Venura-Shiromal/Advanced-Light-Intensity-Indicator/Images/PCB_3D.png

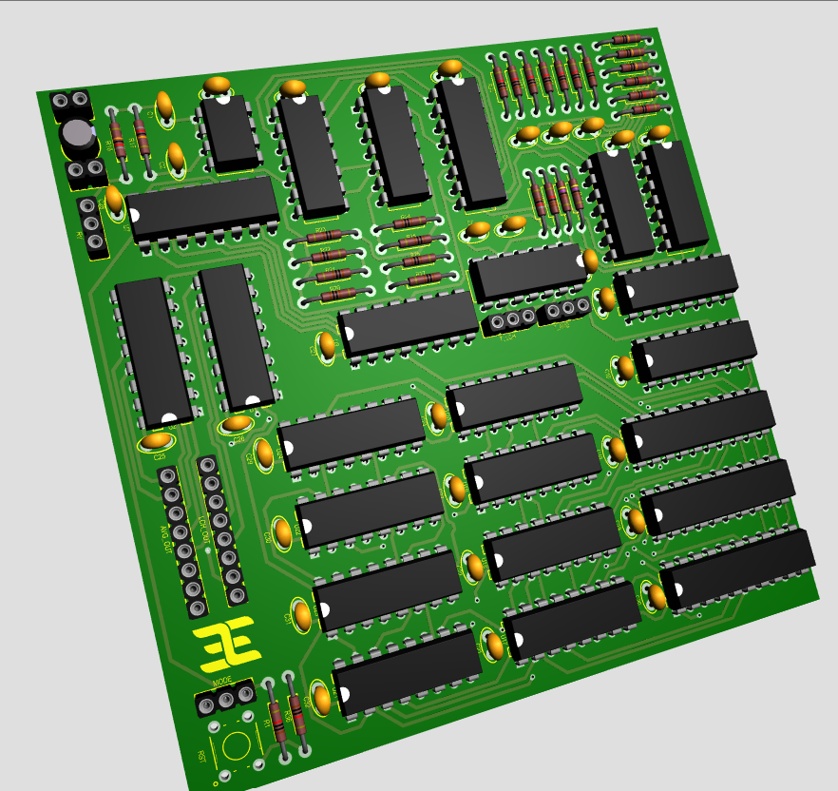
Images/PCB_3D.png
