Venura-Shiromal/Advanced-Light-Intensity-Indicator/Images/PCB_Layout.png

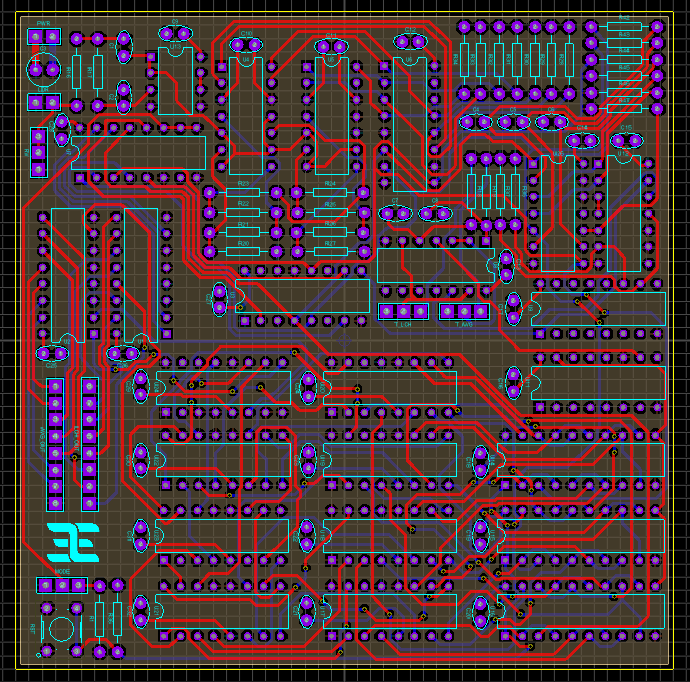
Images/PCB_Layout.png
