Venura-Shiromal/Advanced-Light-Intensity-Indicator/Images/Prototype1.png

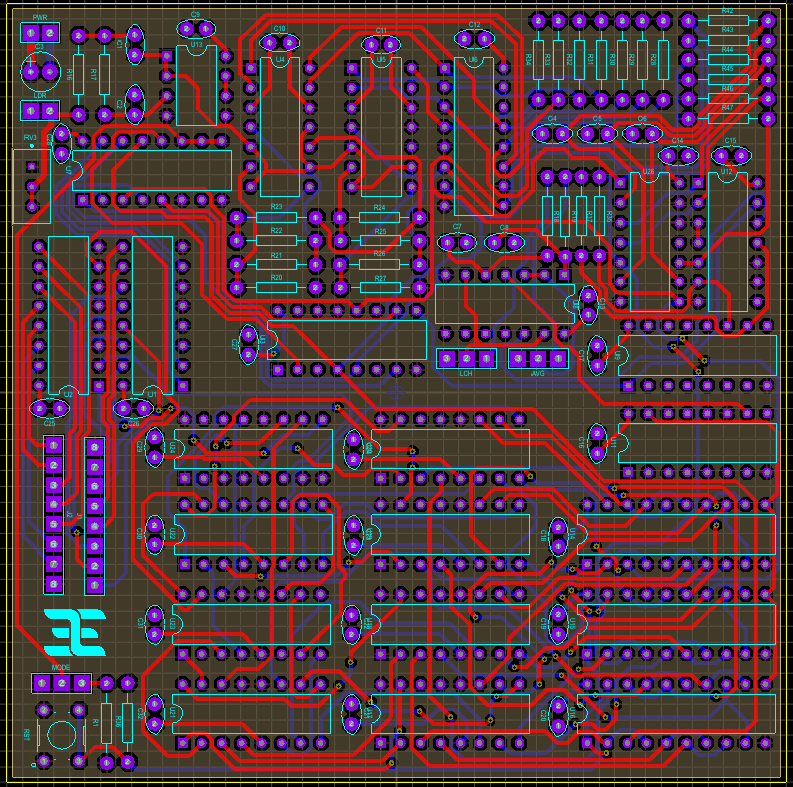
Images/Prototype1.png
