Venura-Shiromal/Advanced-Light-Intensity-Indicator/Simulations/LTSpice/Filter/Plots/Bode_Plot.jpg

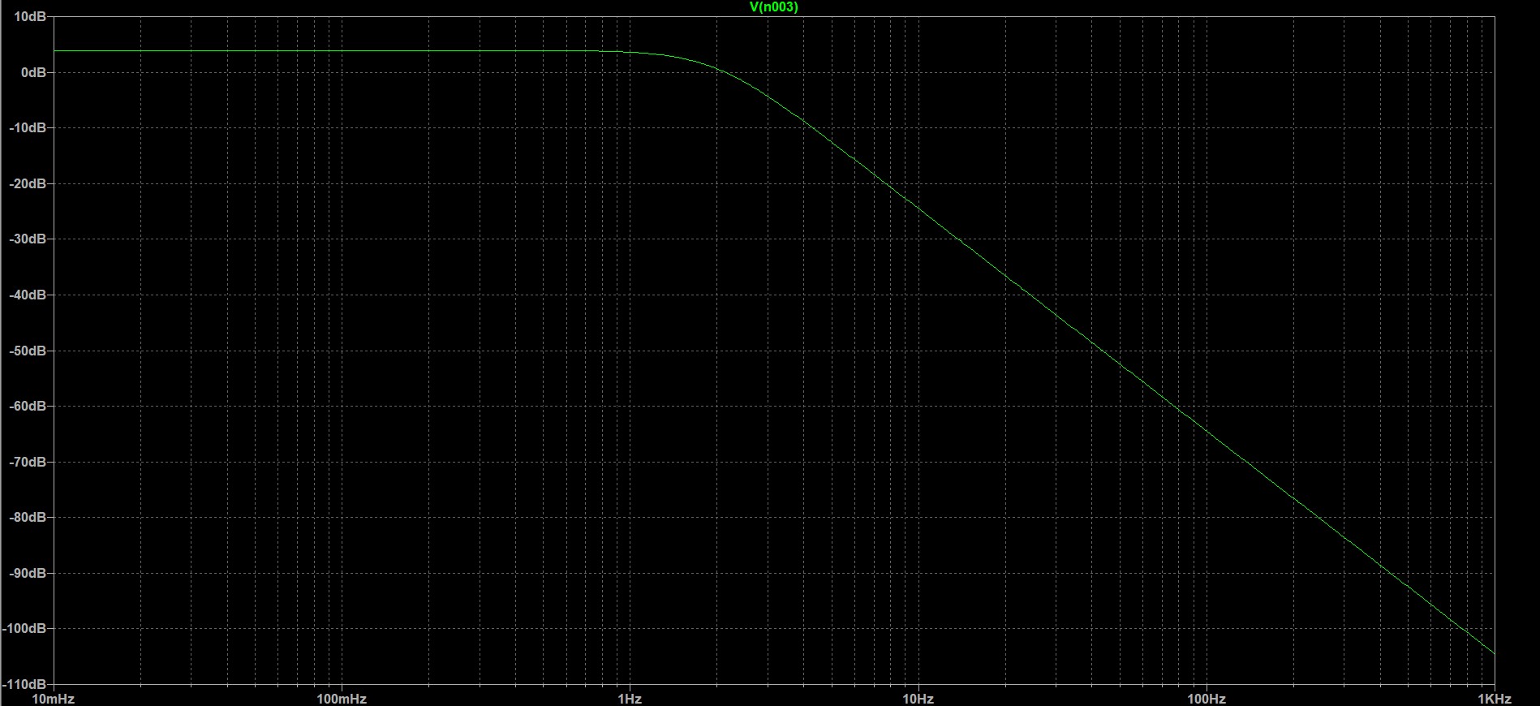
Simulations/LTSpice/Filter/Plots/Bode_Plot.jpg
