Venura-Shiromal/Advanced-Light-Intensity-Indicator/Simulations/LTSpice/Filter/Plots/Bode_Plot_Zoomed.jpg

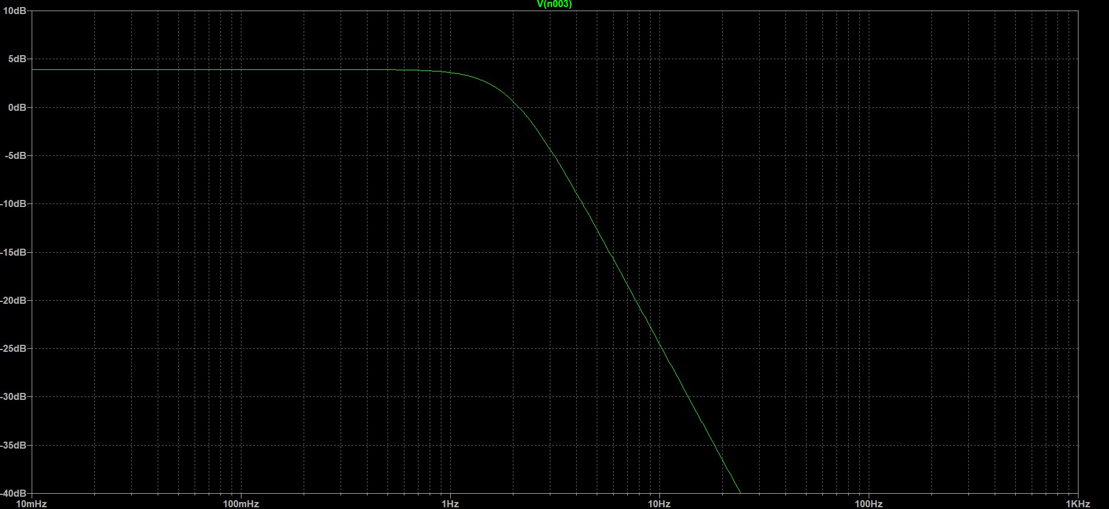
Simulations/LTSpice/Filter/Plots/Bode_Plot_Zoomed.jpg
