Venura-Shiromal/Advanced-Light-Intensity-Indicator/Simulations/LTSpice/Filter/Plots/BodePlot_UnityGain.jpg

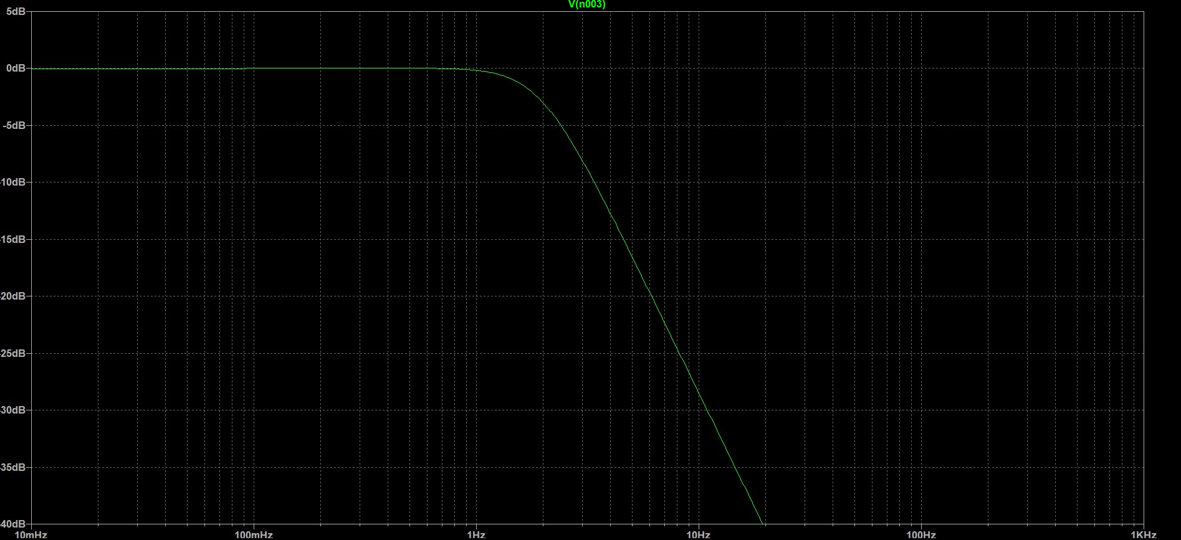
Simulations/LTSpice/Filter/Plots/BodePlot_UnityGain.jpg
