Venura-Shiromal/Advanced-Light-Intensity-Indicator/Simulations/LTSpice/Filter/Plots/BodePlot_UnityGain_v2.jpg

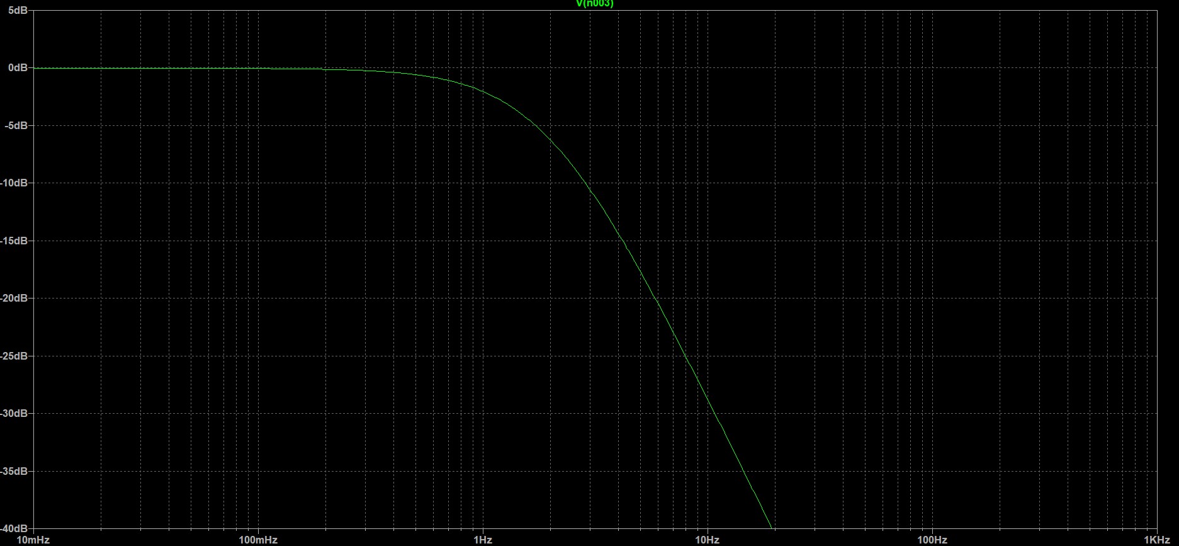
Simulations/LTSpice/Filter/Plots/BodePlot_UnityGain_v2.jpg
