Venura-Shiromal/Advanced-Light-Intensity-Indicator/Documents/Bill_of_Materials.xlsx

Category | Qt. | Value | Description | Store | Unit Price (Rs) | Price
Capacitors | 2 | 1uF | Ceramic (Clock) | Hexa Node | 5 | 10
Capacitors | 29 | 100nF | Ceramic | Hexa Node | 8 | 232
Capacitors | 1 | 100uF | Electrolyt | Duino | 6 | 6
Resistors | 10 | 820k | Resistors (Filter) | Duino | 1.5 | 15
Resistors | 10 | 10k | Resistors (Pull Up/Pull Down) | Duino | 1.5 | 15
Resistors | 14 | 330 | Resistors (7-Segment Display) | Department | 0 | 0
Resistors | 10 | 8.2k | Resistors (Clock) | Duino | 1.5 | 15
Resistors | 8 | 1k | Resistors (Comparator Ladder) | Department | 0 | 0
Resistors | 10 | 100k | Resistors (Change Detector) | Duino | 1.5 | 15
Resistors | 1 | 20k | Potentiometer (Trimmer) | Duino | 45 | 45
Resistors | 1 | 20k | Potentiometer | Duino | 80 | 80
Resistors | 1 | 100k | Potentiometer | Duino | 65 | 65
Integrated Circuits | 2 | CD4511 | 7 Segment BCD Decoder | Department | 0 | 0
Integrated Circuits | 1 | MCP6002 | Filter Op-Amp | Hexa Node | 75 | 75
Integrated Circuits | 2 | LM339N | Flash ADC Comparators | Department | 0 | 0
Integrated Circuits | 1 | 74HC148 | Priority Encoder | Department | 0 | 0
Integrated Circuits | 1 | CD4053 | Multiplexer | Hexa Node | 42 | 42
Integrated Circuits | 1 | 74HC14 | Inverter | Hexa Node | 110 | 110
Integrated Circuits | 1 | CD40175 | Quad D Flip Flop | Hexa Node | 200 | 200
Integrated Circuits | 2 | CD4040 | 12 Stage Counter | Hexa Node | 65 | 130
Integrated Circuits | 1 | 74HC32N | OR | Duino | 55 | 55
Integrated Circuits | 3 | 74LS273 | Octal D Flip Flop | Hexa Node | 110 | 330
Integrated Circuits | 1 | CD4070 | XOR | Hexa Node | 75 | 75
Integrated Circuits | 8 | 74LS83 | 4-Bit Full Adder | Hexa Node | 120 | 960
Integrated Circuits | 1 |  | 8-pin IC Socket | Duino | 12 | 12
Integrated Circuits | 20 |  | 16-pin IC Socket | Duino | 20 | 400
Integrated Circuits | 3 |  | 20-pin IC Socket | Duino | 30 | 90
Miscellaneous | 1 |  | LDR | Department | 0 | 0
Miscellaneous | 2 |  | 7 Segment Display | Department | 0 | 0
Miscellaneous | 1 |  | Switch |  |  | 0
Miscellaneous | 1 |  | Push Button | Hexa Node | 10 | 10
 |  |  |  |  |  | 2987
 |  | Order | Price | Delivery | Total
 |  | Hexanode | 2174 | 500 | 2674
 |  | Duino | 813 | 480 | 1293
 |  | Total | 2987 | 980 | 3967
