Venura-Shiromal/Advanced-Light-Intensity-Indicator/Documents/Final_Circuit_4L.pdf

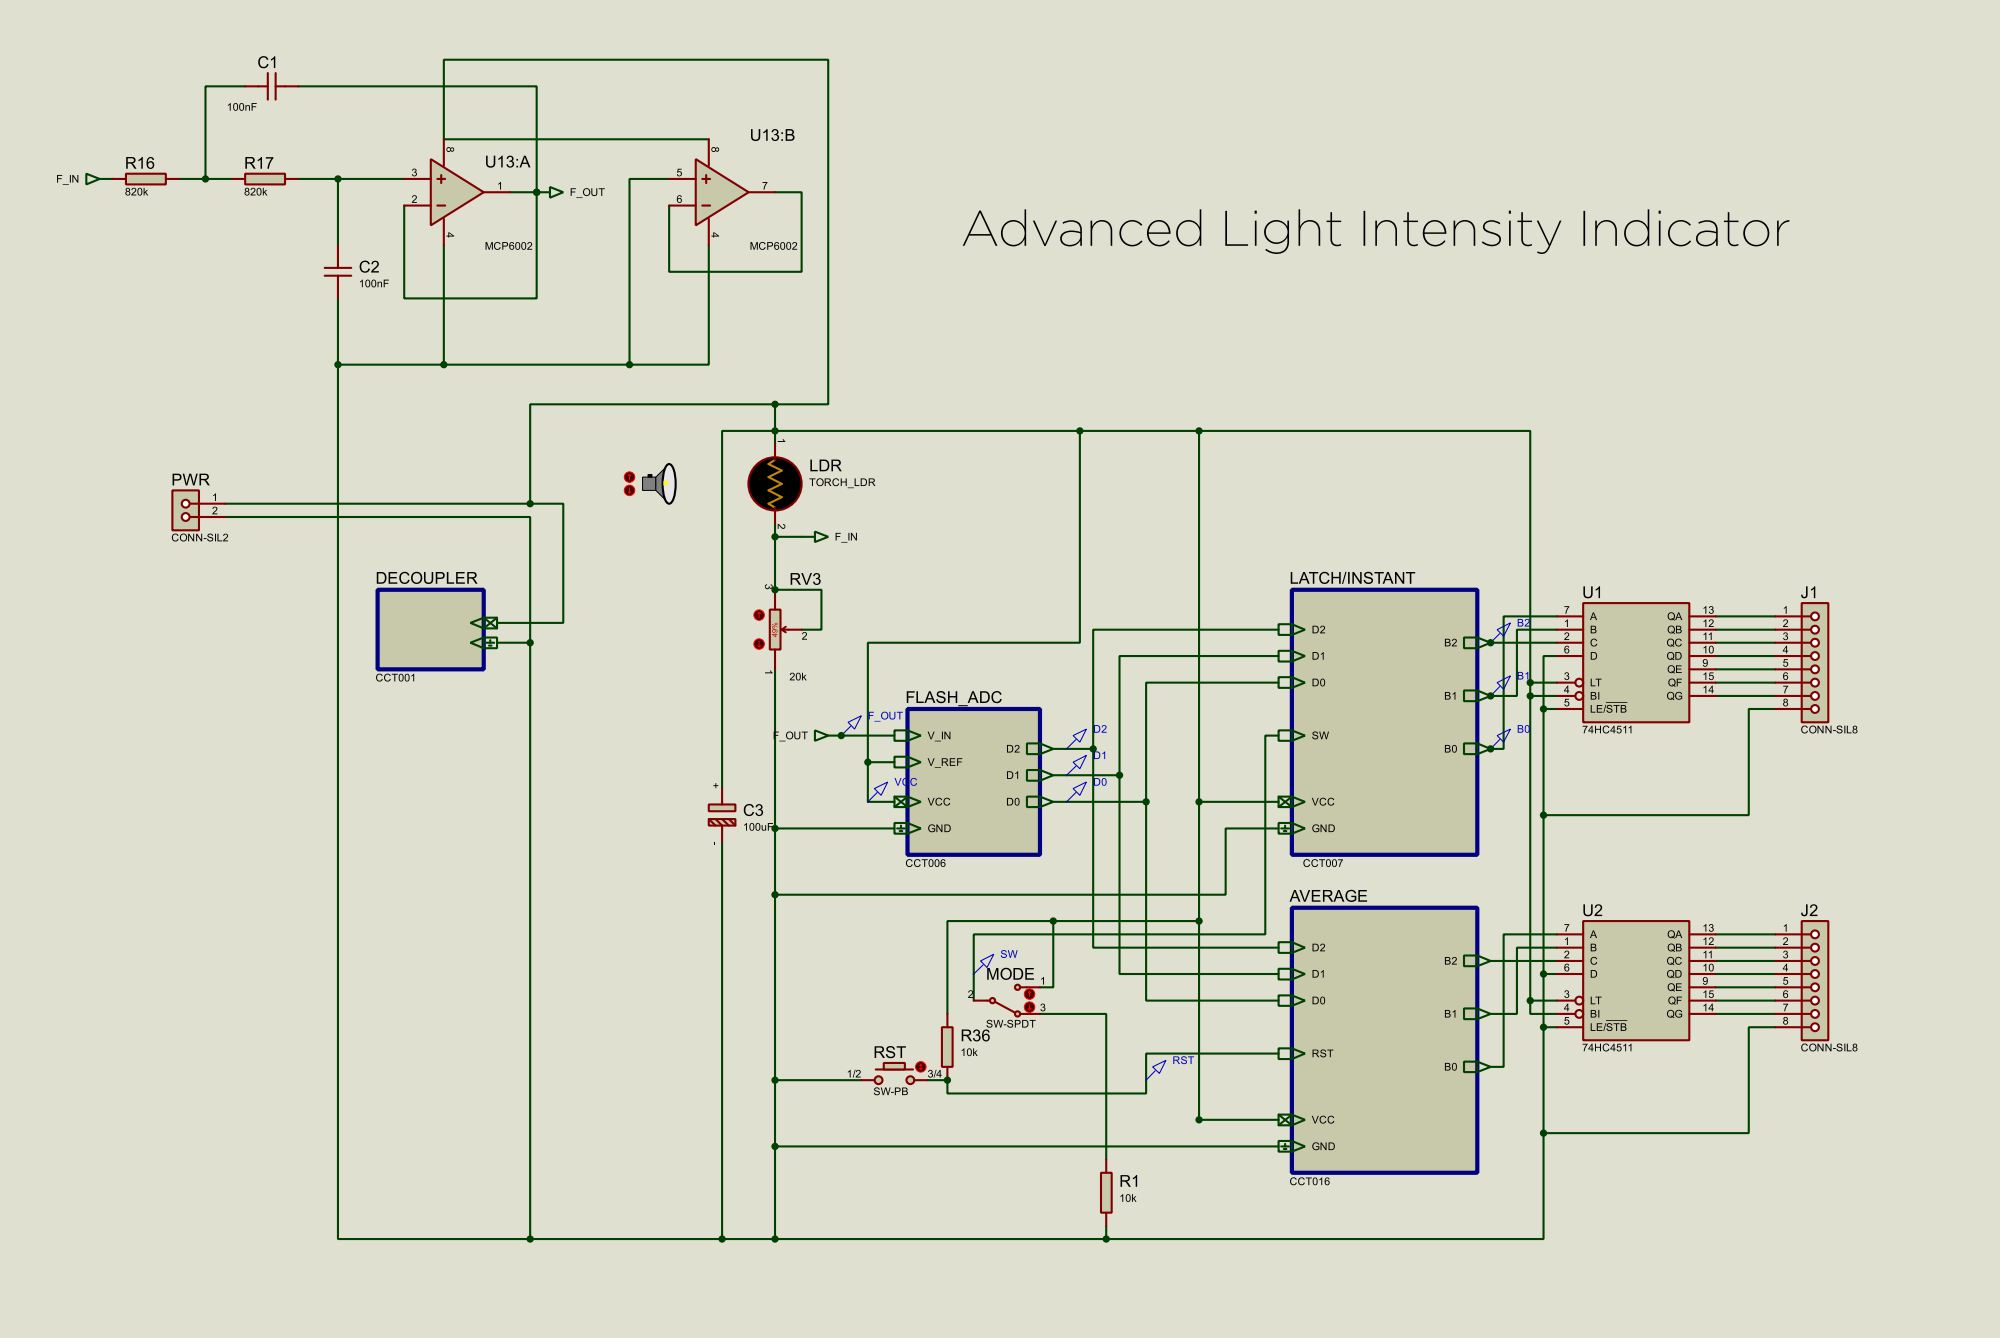
[picture p16: page 1]



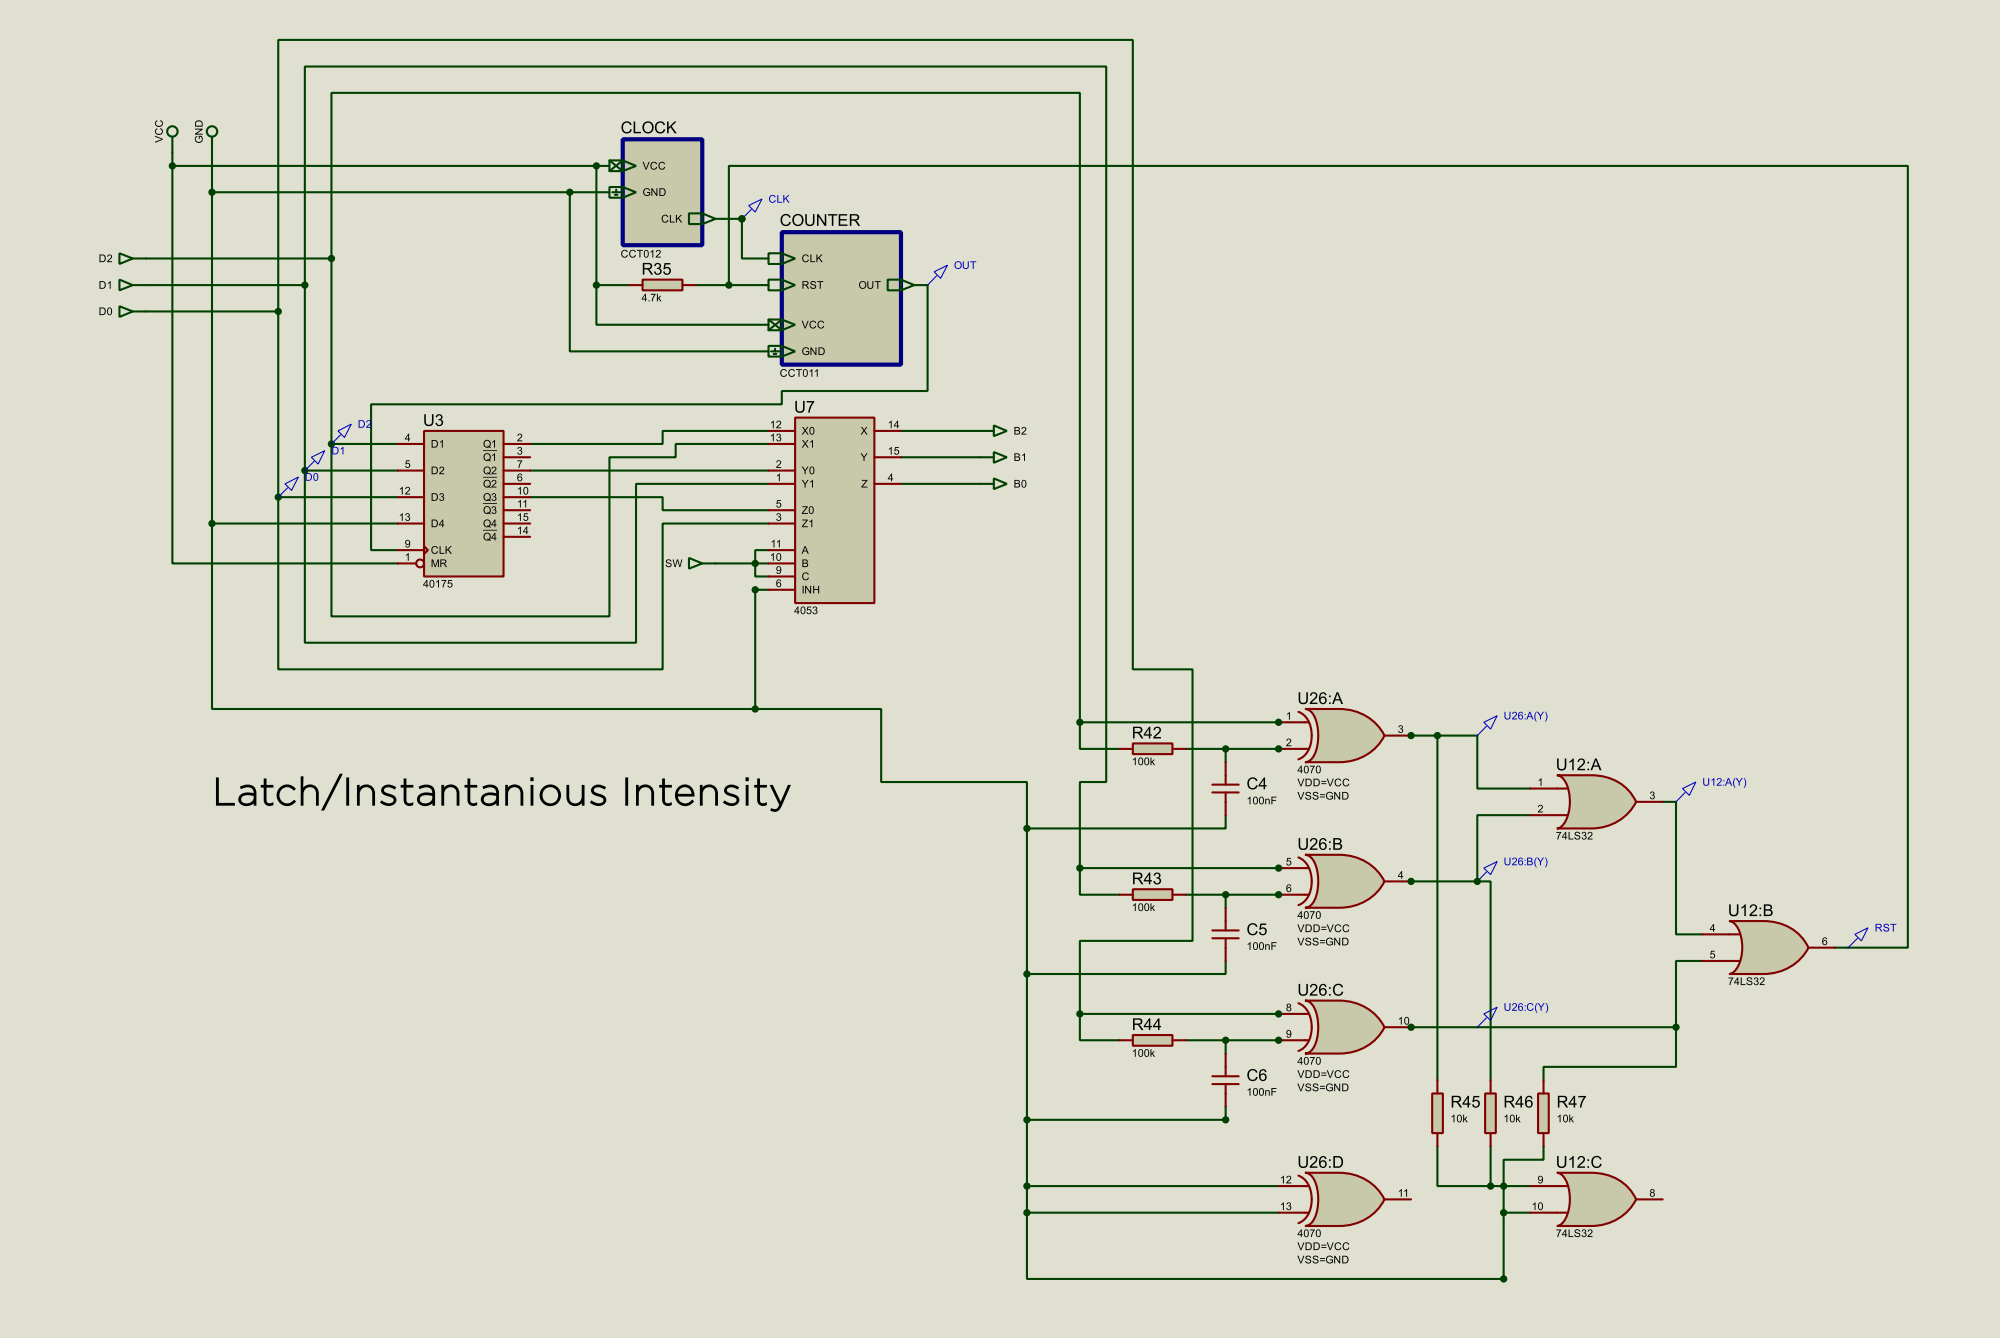
[picture p17: page 4]

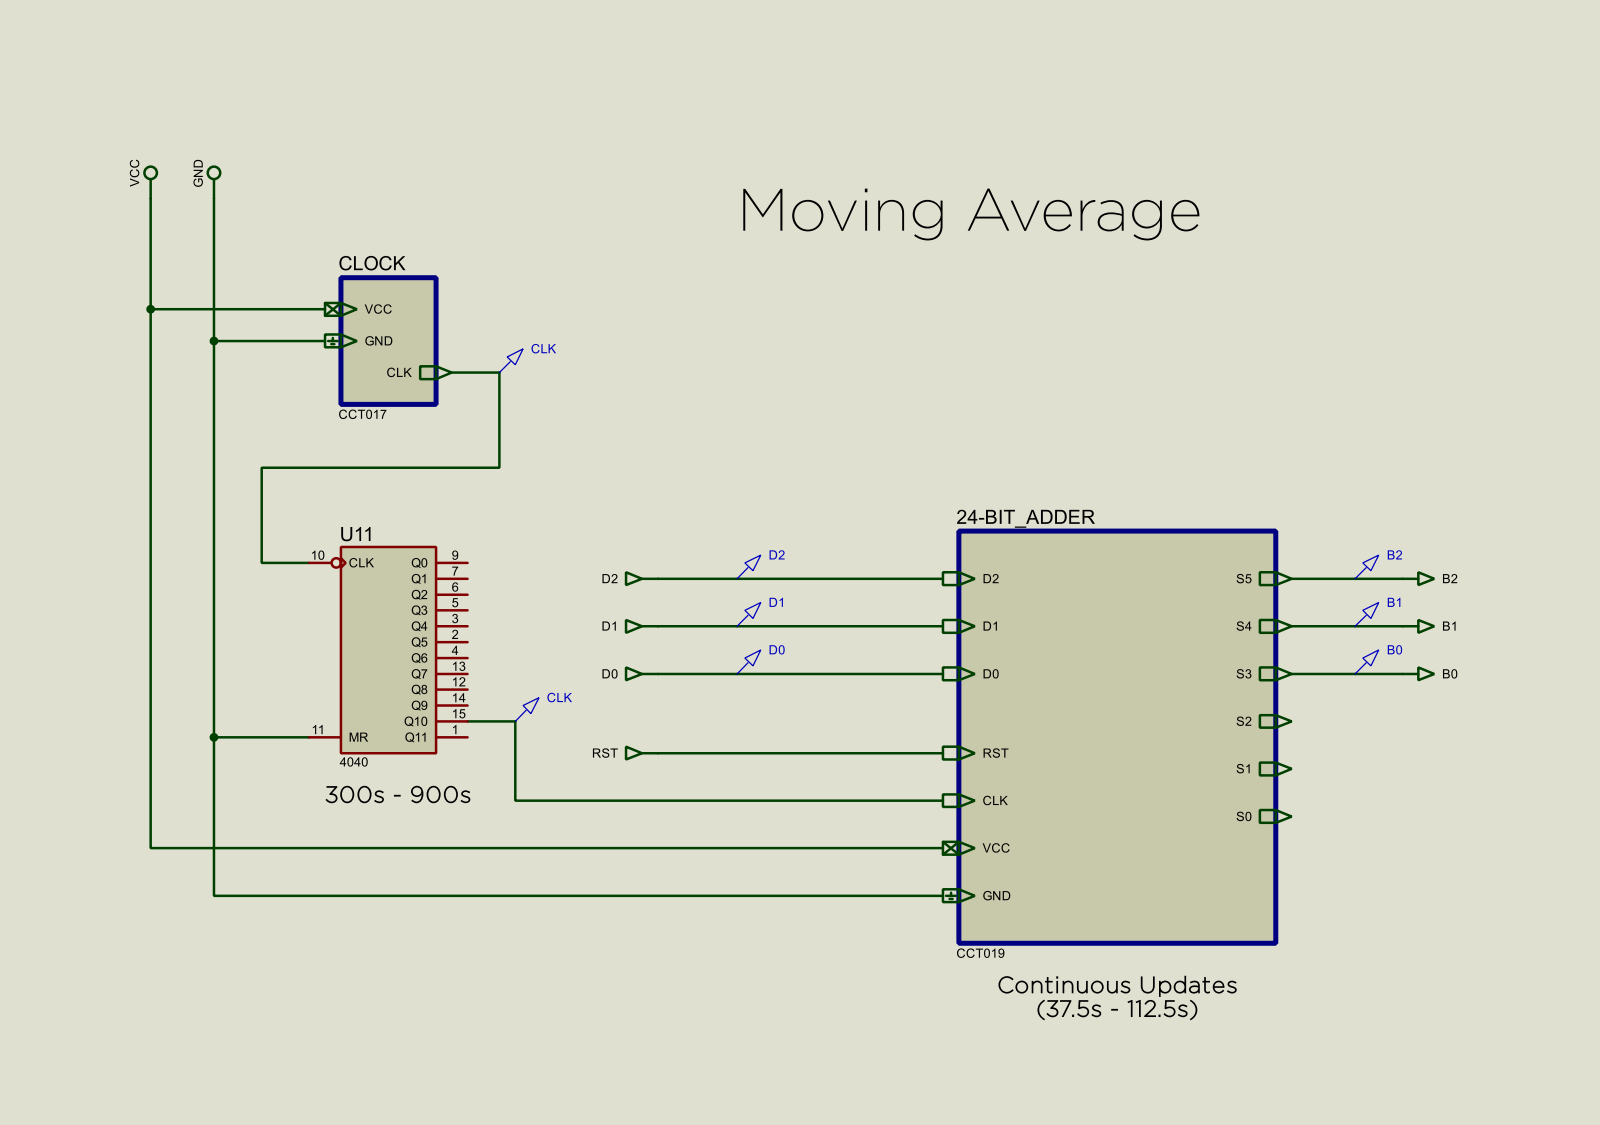
[picture p18: page 5]

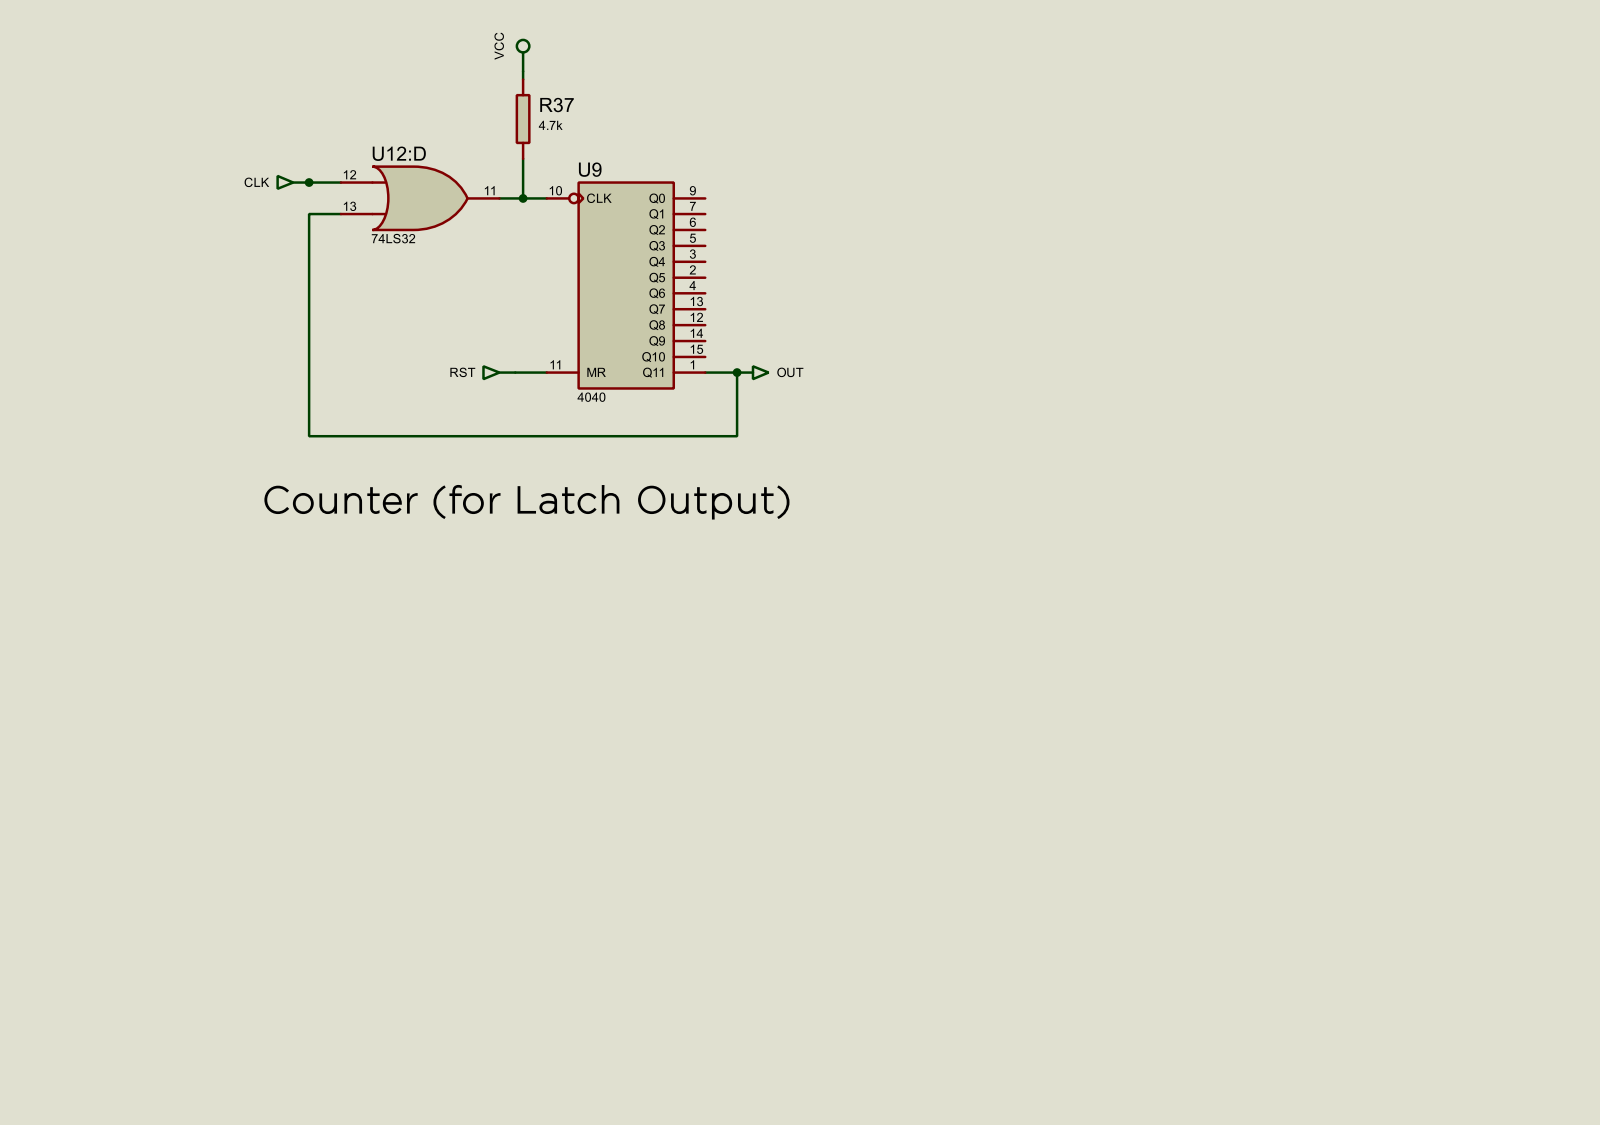
[picture p19: page 6]

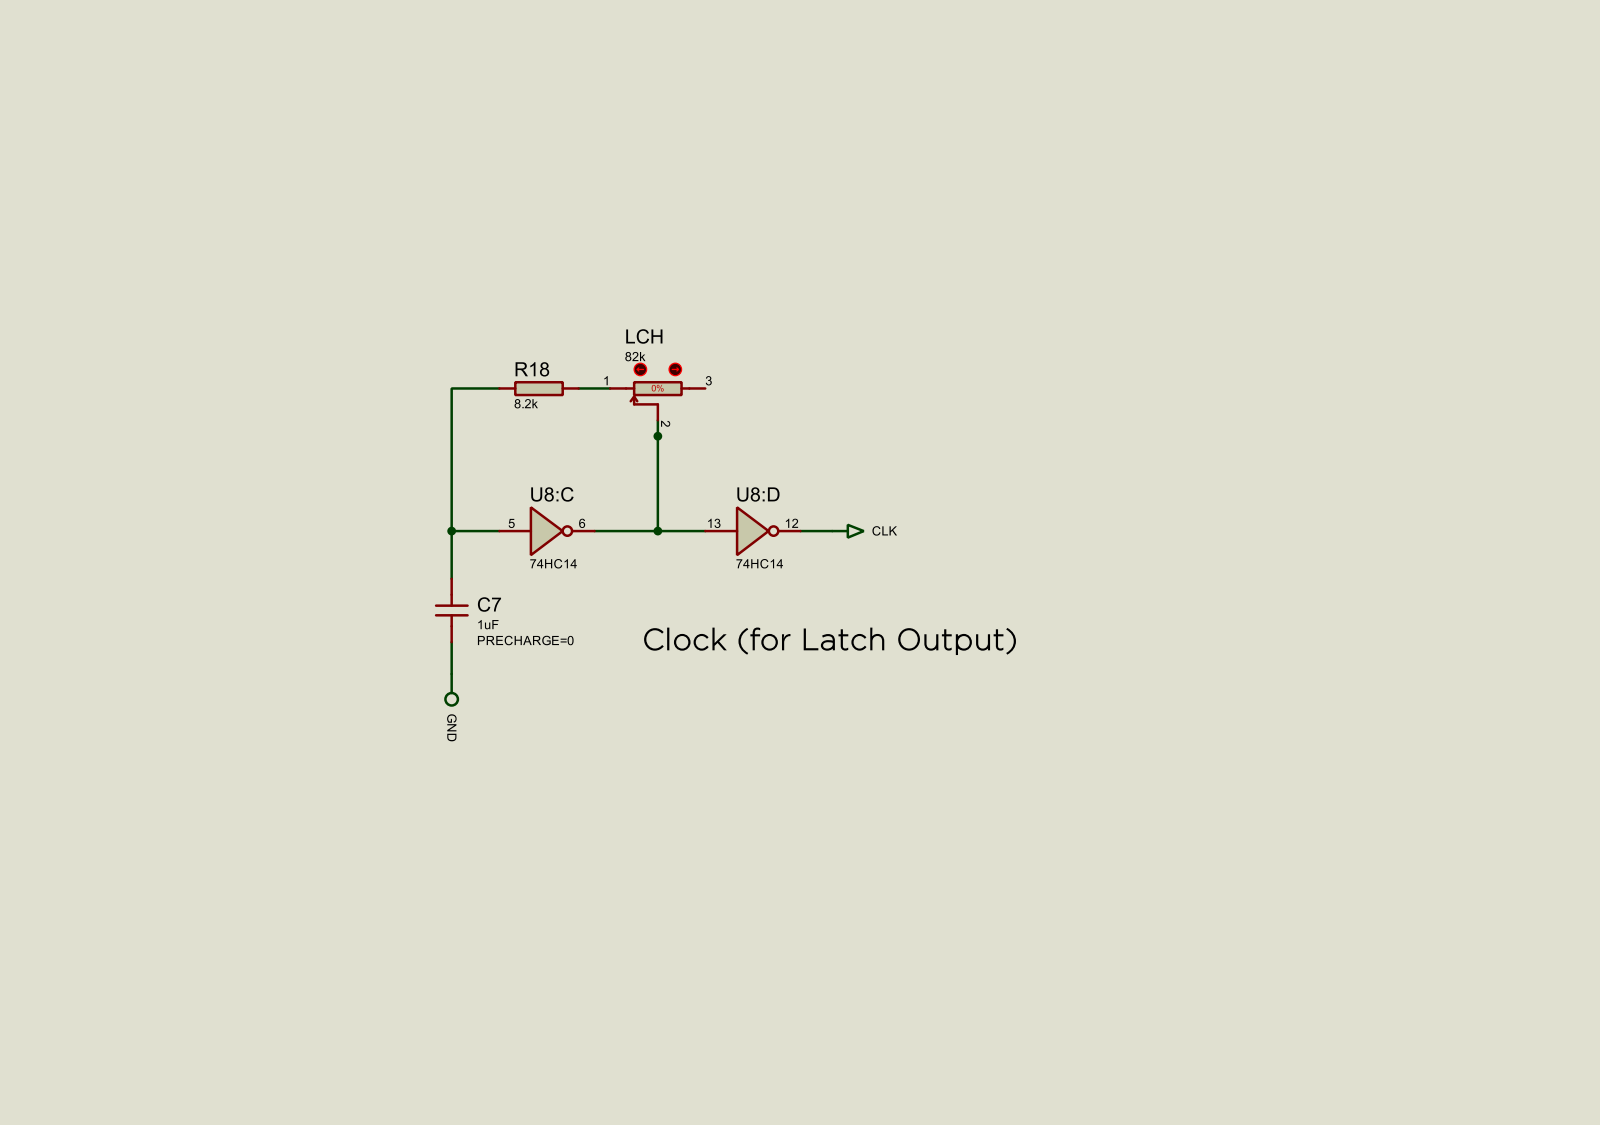
[picture p20: page 7]


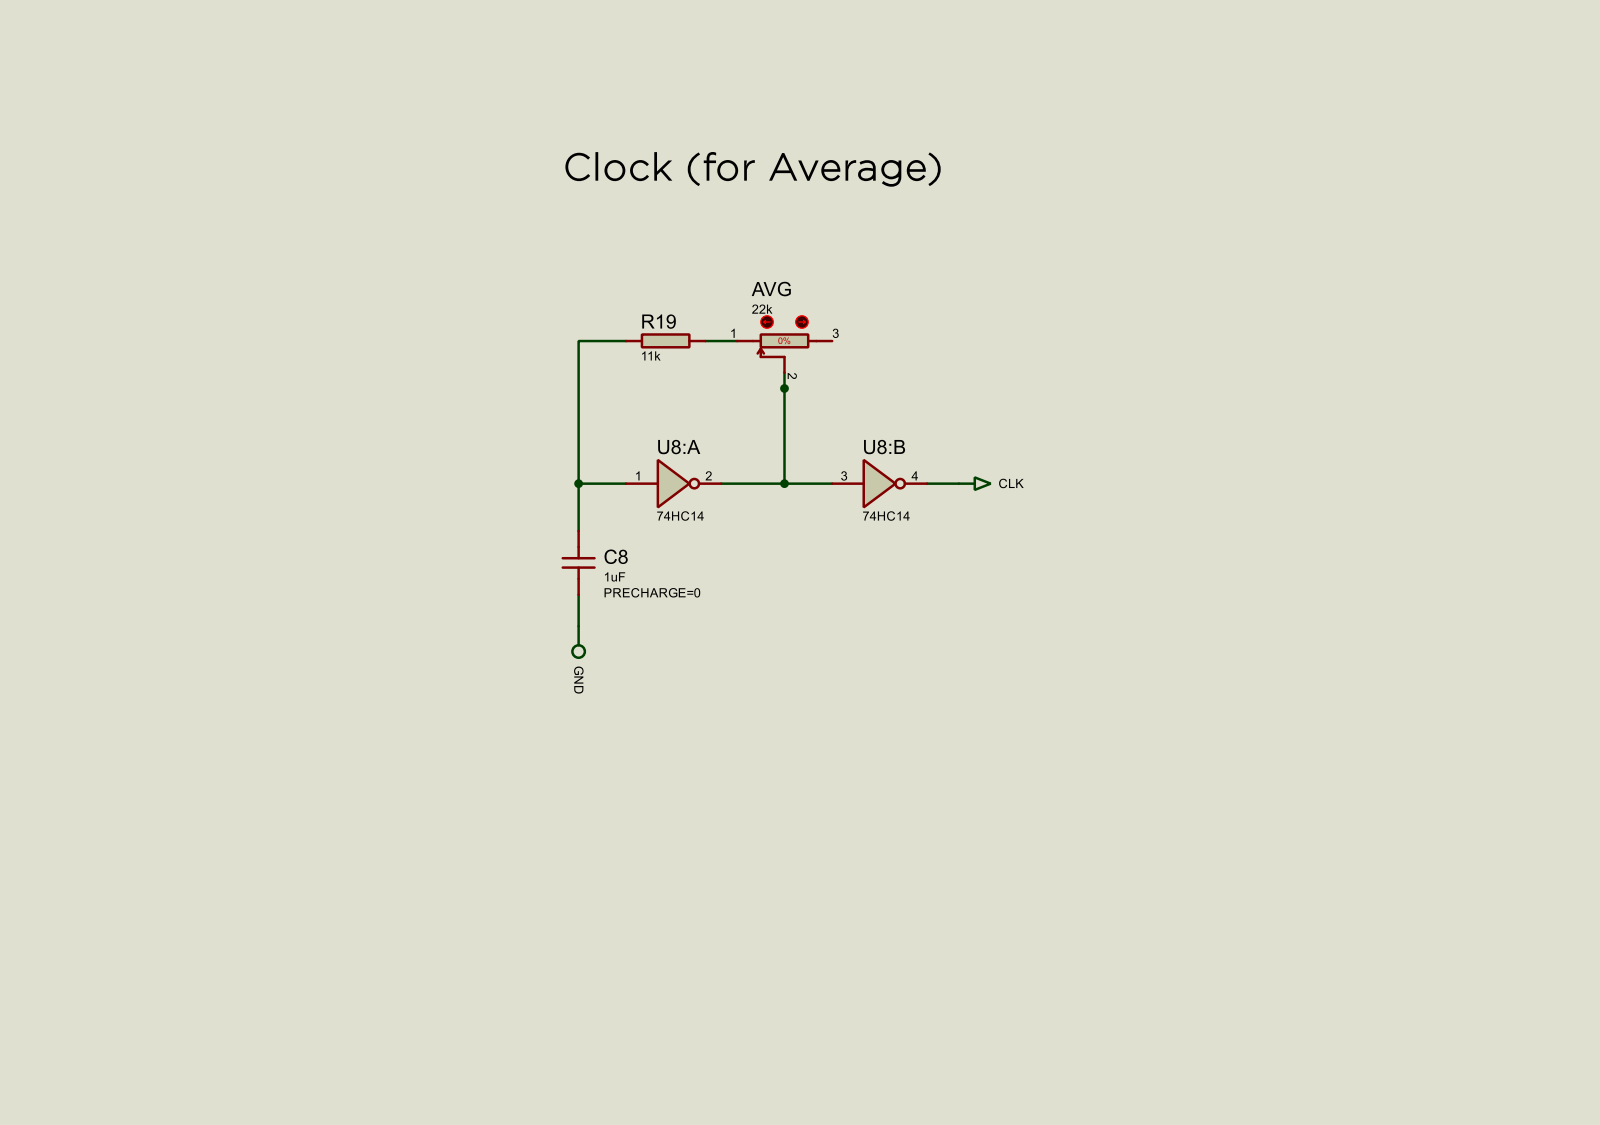
[picture p21: page 9]
