Venura-Shiromal/Advanced-Light-Intensity-Indicator/Simulations/LTSpice/Filter/Sallen-Key_LowPass_UnityGain.asc

C1: cap; 100n
C2: cap; 100n
R1: res; 820k
R2: res; 820k
U1: UniversalOpAmp2
V1: voltage; ""; AC 1 0
V2: battery; 12
V3: battery; 12
Named nets: 0
.ac dec 25 0.01 1000
