Venura-Shiromal/Advanced-Light-Intensity-Indicator/Simulations/LTSpice/Filter/Sallen-Key_LowPass.asc

C1: cap; 10µ
C2: cap; 10µ
R1: res; 8.2k
R2: res; 8.2k
R3: res; 4.7k
R4: res; 8.2k
U1: UniversalOpAmp2
V1: voltage; ""; AC 1 0
V2: battery; 12
V3: battery; 12
Named nets: 0
.ac dec 25 0.01 1000
