Venura-Shiromal/Advanced-Light-Intensity-Indicator/(list of files, drawings)

Other design files:
Simulations/Proteus/Final_Circuit.pdsprj
Simulations/Proteus/Final_Circuit_4L.pdsprj
Simulations/Proteus/Final_Circuit_with_Timer.pdsprj
