Venura-Shiromal/Advanced-Light-Intensity-Indicator/(commit log)

2026-09-17 Initialization
    Added the project description and added detailed overview, key features, technical specifications, and circuit architecture.
2026-09-18 Designed and simulated a major part
    Got things done such as filter, priority encoder, flash ADC (including the encoder), and a multiplexer
2026-09-19 Successfully simulated current value indicator subsystem
    Built subcircuits such as change detector, counter, latch system, and also some modifications to the current subcircuits. Finished simulating the current value indication subsystem.
    [FrequencyTest_Max.csv, FrequencyTest_Min.csv]
2026-09-19 Finished Designing the entire circuit
    Designed the whole circuit. Simulations are ongoing. Tests need to be done. Currently have implemented the circuit with ideal components.
2026-09-20 Update progress in README for circuit simulation
2026-09-20 Finalized the Falstad circuit with custom clocks
    Clocks + Useful Datasheets
    [Average_Timer_(LowerBound).csv, FrequencyTest_Max.csv, FrequencyTest_Min.csv, Latch_Timer_(LowerBound).csv]
2026-09-22 Simulation with ICs (in progress)
    1.. Proteus project where I used real world ICs instead of pure gates and other components.
    2. Improvements in the filter and Falstad circuit.
    [Final_Circuit.pdsprj]
2026-09-22 Finished building the circuit with ICs
    [Final_Circuit.pdsprj]
2026-09-22 Simulation Completed with ICs
    Simulation with ICs Completed
    Plus some minor bug fixes
    [Final_Circuit.pdsprj]
2026-09-23 Changed ICs as they are available
    In the market, I didn't have what I needed so I had to adjust it as necessary.
    [Final_Circuit.pdsprj]
2026-09-24 Clean Finalized Circuit
    The final circuit with real ICs that are supposed to be used for building this is finally tested in simulation and worked !00% after some minor upgrades and bug fixes
    [Final_Circuit.pdsprj]
2026-09-25 Changes due to out of stock
    1. Had to change one of ICs due to the lack of stock.
    2. Created the BOM.
    [Bill_of_Materials.xlsx, Final_Circuit.pdsprj]
2026-09-26 PCB Layout Halfway Done
    Only the Adder ICs and Displays left
    [Final_Circuit.pdsprj]
2026-10-02 4 Layer PCB Layout Finished
    Had to design it in 4 layers. (2 layer circuit was too bulky)
    And finished the whole 4 layer circuit.
2026-10-08 Fixing a physical issue
    1. Changed the timer for average system.
    2. Fixed resistor and capacitor values with physically tested values.
2026-10-13 Finished testing on breadboard
    Finished whole breadboard implementation.
    Fixed minor issues with the schematic and the PCB layout.
2026-10-15 Finalized PCB Design
    Finished some minor changes and finalized so I can order it.
2026-10-15 Progress so far
    Updated tasks in project checklist and added PCB design details.
